yosihisa/CubBleMonitor/PCB/CubBELMonitor/CubBELMonitor.kicad_pcb

## KiCad design PCB/CubBELMonitor/CubBELMonitor.kicad_pcb (2021-03-30)

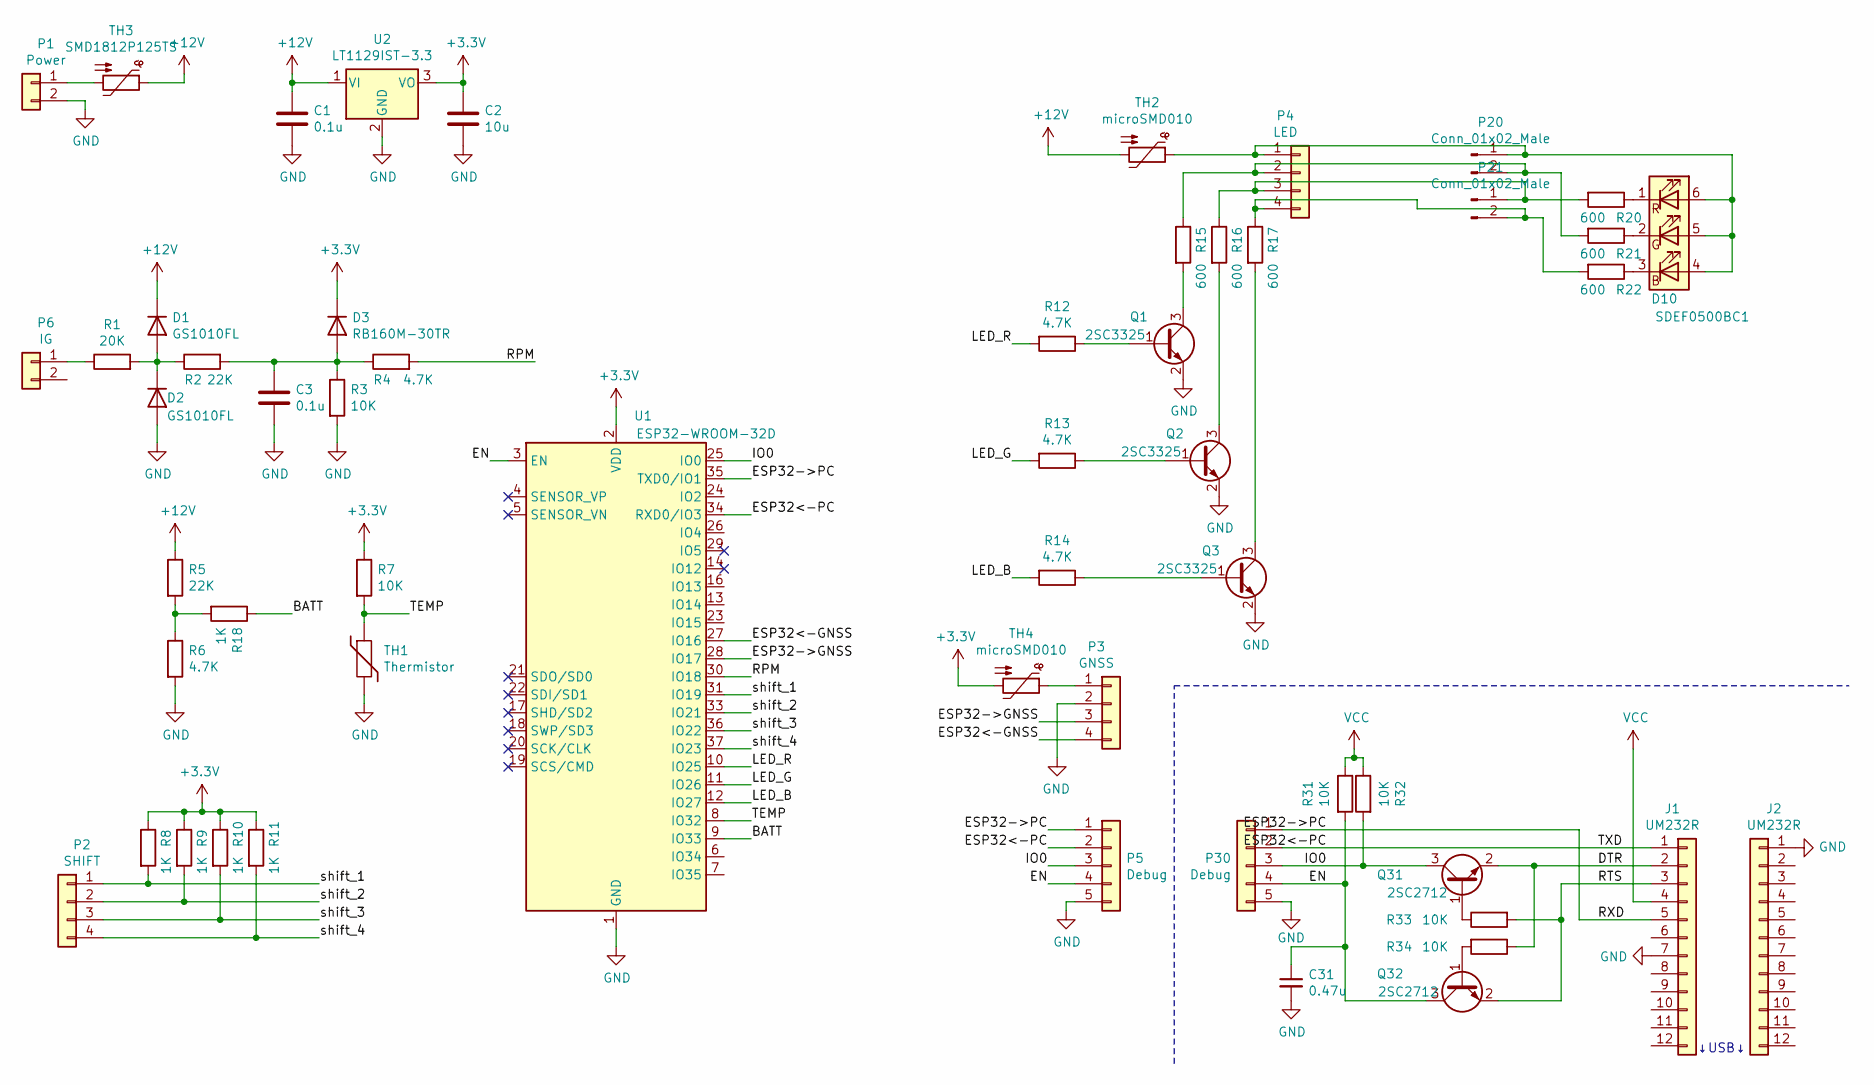
[picture p1: schematic CubBELMonitor.sch]

Parts:
C1, C3: 0.1u; C_0603_1608Metric_Pad1.05x0.95mm_HandSolder
C2: 10u; C_0805_2012Metric_Pad1.15x1.40mm_HandSolder
C31: 0.47u; C_0805_2012Metric_Pad1.15x1.40mm_HandSolder
D1, D2: GS1010FL; D_SOD-123
D3: RB160M-30TR; D_SOD-123
D10: SDEF0500BC1; LED_Avago_PLCC6_3x2.8mm
J1, J2: UM232R; PinHeader_1x12_P2.54mm_Vertical
P1: Power; JST_XH_S2B-XH-A_1x02_P2.50mm_Horizontal
P2: SHIFT; JST_XH_S4B-XH-A_1x04_P2.50mm_Horizontal
P3: GNSS; JST_XH_S4B-XH-A_1x04_P2.50mm_Horizontal
P4: LED; JST_XH_S4B-XH-A_1x04_P2.50mm_Horizontal
P5: Debug; PinSocket_1x05_P2.54mm_Vertical
P6: IG; JST_XH_B2B-XH-A_1x02_P2.50mm_Vertical
P20, P21: Conn_01x02_Male; 3mmLED_
P30: Debug; PinHeader_1x05_P2.54mm_Vertical
Q1, Q2, Q3: 2SC3325; SC-59
Q31, Q32: 2SC2712; SC-59
R1: 20K; R_0603_1608Metric_Pad1.05x0.95mm_HandSolder
R2, R5: 22K; R_0603_1608Metric_Pad1.05x0.95mm_HandSolder
R3, R7, R31, R32, R33, R34: 10K; R_0603_1608Metric_Pad1.05x0.95mm_HandSolder
R4, R6, R12, R13, R14: 4.7K; R_0603_1608Metric_Pad1.05x0.95mm_HandSolder
R8, R9, R10, R11, R18: 1K; R_0603_1608Metric_Pad1.05x0.95mm_HandSolder
R15, R16, R17, R20, R21, R22: 600; R_0603_1608Metric_Pad1.05x0.95mm_HandSolder
TH1: Thermistor; R_0603_1608Metric_Pad1.05x0.95mm_HandSolder
TH2, TH4: microSMD010; R_1210_3225Metric_Pad1.42x2.65mm_HandSolder
TH3: SMD1812P125TS; R_1812_4532Metric_Pad1.30x3.40mm_HandSolder
U1: ESP32-WROOM-32D; ESP32-WROOM-32
U2: LT1129IST-3.3; SOT-223-3_TabPin2

Connections:
+3V3: C2.1, D3.1 (K), R7.1, R8.1, R9.1, R10.1, R11.1, TH4.2, U1.2 (VDD), U2.3 (VO)
+12V: C1.1, D1.1 (K), R5.1, TH2.2, TH3.1, U2.1 (VI)
/BATT: R18.1, U1.9 (IO33)
/DTR: J1.2, Q31.2 (E), R34.1
/EN: C31.1, P5.4, P30.4, Q32.3 (C), R31.2, U1.3 (EN)
/ESP32->GNSS: P3.3, U1.28 (IO17)
/ESP32->PC: J1.5, P5.1, P30.1, U1.35 (TXD0/IO1)
/ESP32<-GNSS: P3.4, U1.27 (IO16)
/ESP32<-PC: J1.1, P5.2, P30.2, U1.34 (RXD0/IO3)
/IO0: P5.3, P30.3, Q31.3 (C), R32.2, U1.25 (IO0)
/LED_B: R14.2, U1.12 (IO27)
/LED_G: R13.2, U1.11 (IO26)
/LED_R: R12.2, U1.10 (IO25)
/RPM: R4.2, U1.30 (IO18)
/RTS: J1.3, Q32.2 (E), R33.2
/TEMP: R7.2, TH1.1, U1.8 (IO32)
/shift_1: P2.1, R8.2, U1.31 (IO19)
/shift_2: P2.2, R9.2, U1.33 (IO21)
/shift_3: P2.3, R10.2, U1.36 (IO22)
/shift_4: P2.4, R11.2, U1.37 (IO23)
GND: C1.2, C2.2, C3.2, C31.2, D2.2 (A), J1.7, J2.1, P1.2, P3.2, P5.5, P30.5, Q1.2 (E), Q2.2 (E), Q3.2 (E), R3.2, R6.2, TH1.2, U1.1 (GND), U1.15 (GND), U1.38 (GND), U1.39 (GND), U2.2 (GND)
unnamed: C3.1, D3.2 (A), R2.2, R3.1, R4.1
unnamed: D1.2 (A), D2.1 (K), R1.2, R2.1
unnamed: D10.1 (RK), R20.1
unnamed: D10.2 (GK), R21.1
unnamed: D10.3 (BK), R22.1
unnamed: D10.4 (BA), D10.5 (GA), D10.6 (RA), P4.1, P20.1, TH2.1
unnamed: P1.1, TH3.2
unnamed: P3.1, TH4.1
unnamed: P6.1, R1.1
unnamed: P4.2, P20.2, R15.1, R21.2
unnamed: P4.3, P21.1, R16.1, R20.2
unnamed: P4.4, P21.2, R17.1, R22.2
unnamed: Q1.1 (B), R12.1
unnamed: Q1.3 (C), R15.2
unnamed: Q2.1 (B), R13.1
unnamed: Q2.3 (C), R16.2
unnamed: Q3.1 (B), R14.1
unnamed: Q3.3 (C), R17.2
unnamed: Q31.1 (B), R33.1
unnamed: Q32.1 (B), R34.2
unnamed: R5.2, R6.1, R18.2
VCC: J1.4, R31.1, R32.1

Notes on the sheet:
↓USB↓

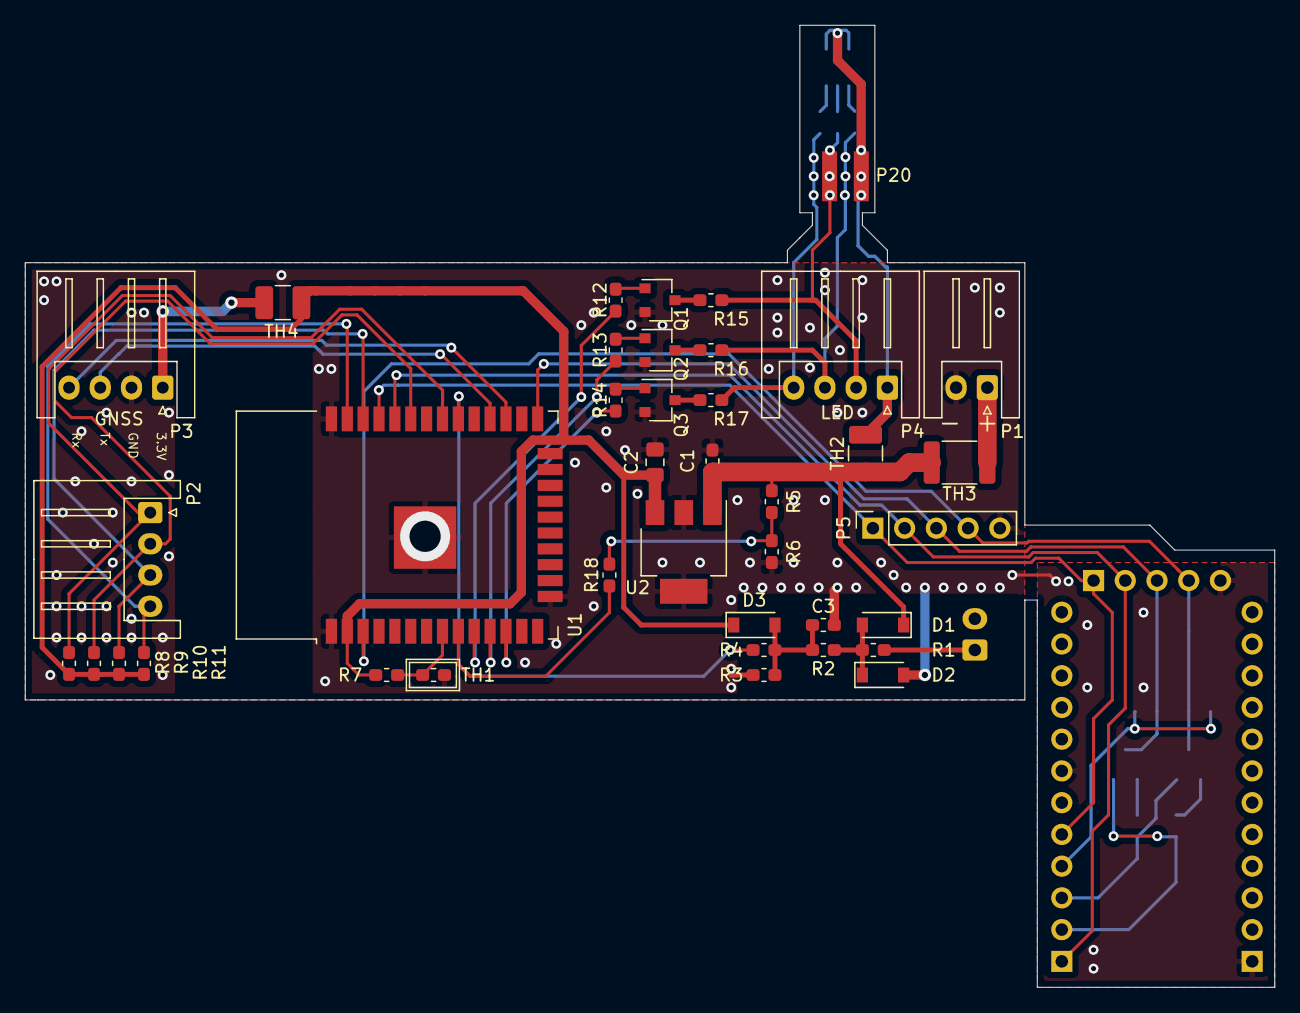
[picture p2: board CubBELMonitor.kicad_pcb from above]

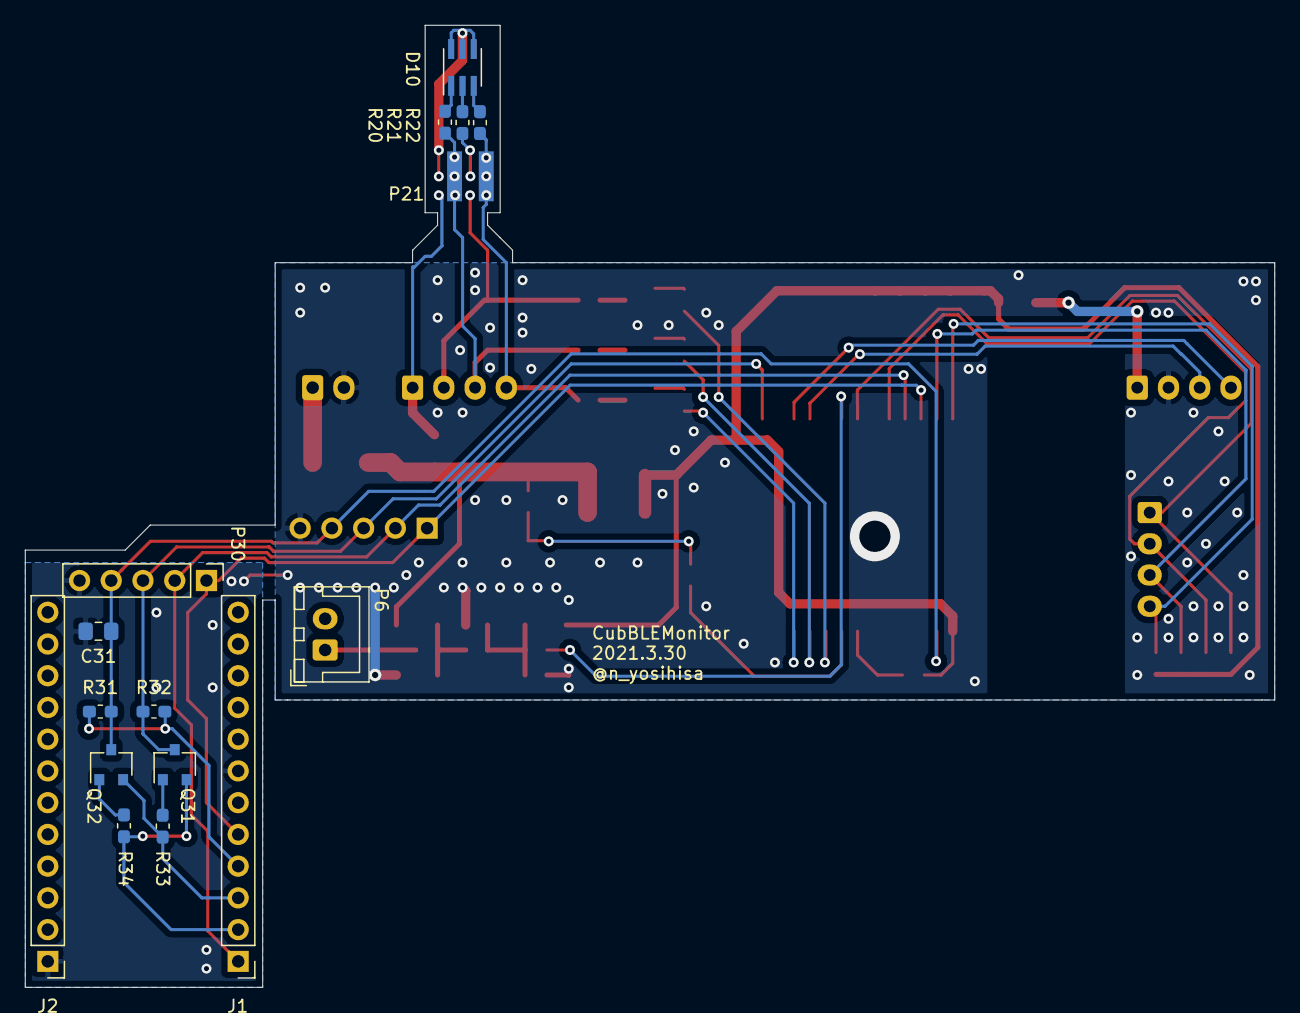
[picture p3: board CubBELMonitor.kicad_pcb from below]

Board: 2 copper layers, 100.0 x 77.0 mm, 55 parts (16 on the bottom side), 43 nets.
