yosihisa/CubBleMonitor/(commit log)

2021-02-07 GNSS追加
2021-02-07 UI作成
2021-02-07 UI更新
2021-02-07 時計追加 UI調整
2021-02-09 時計修正
2021-02-12 回路図作成
    [CubBELMonitor.kicad_pcb, CubBELMonitor.sch]
2021-02-13 速度色変更
2021-02-14 内蔵温度センサ有効化
2021-03-26 ボード追加
    [CubBELMonitor.kicad_pcb, CubBELMonitor.sch]
2021-03-30 基板更新
    [CubBELMonitor.kicad_pcb, CubBELMonitor.sch]
2021-03-30 Gerber追加
    [CubBELMonitor-B_Cu.gbl, CubBELMonitor-B_Mask.gbs, CubBELMonitor-B_SilkS.gbo, CubBELMonitor-Edge_Cuts.gm1, CubBELMonitor-F_Cu.gtl, CubBELMonitor-F_Mask.gts, CubBELMonitor-F_SilkS.gto, CubBELMonitor.drl]
2021-03-30 自動再接続追加
2021-04-06 タコメータの分解能向上
2021-04-06 GNSS以外の全機能を追加
2021-04-07 ノイズ対策追加
2021-04-09 旧ファイル移動
2021-04-09 メーターレイアウト更新
2022-08-13 viewportの変更
2022-08-13 倍率固定
2022-08-13 PWAに仮対応
2022-08-13 レイアウト変更
